felippetuma/vinheria-full/docs/imgs/dashboard/dashboard.png

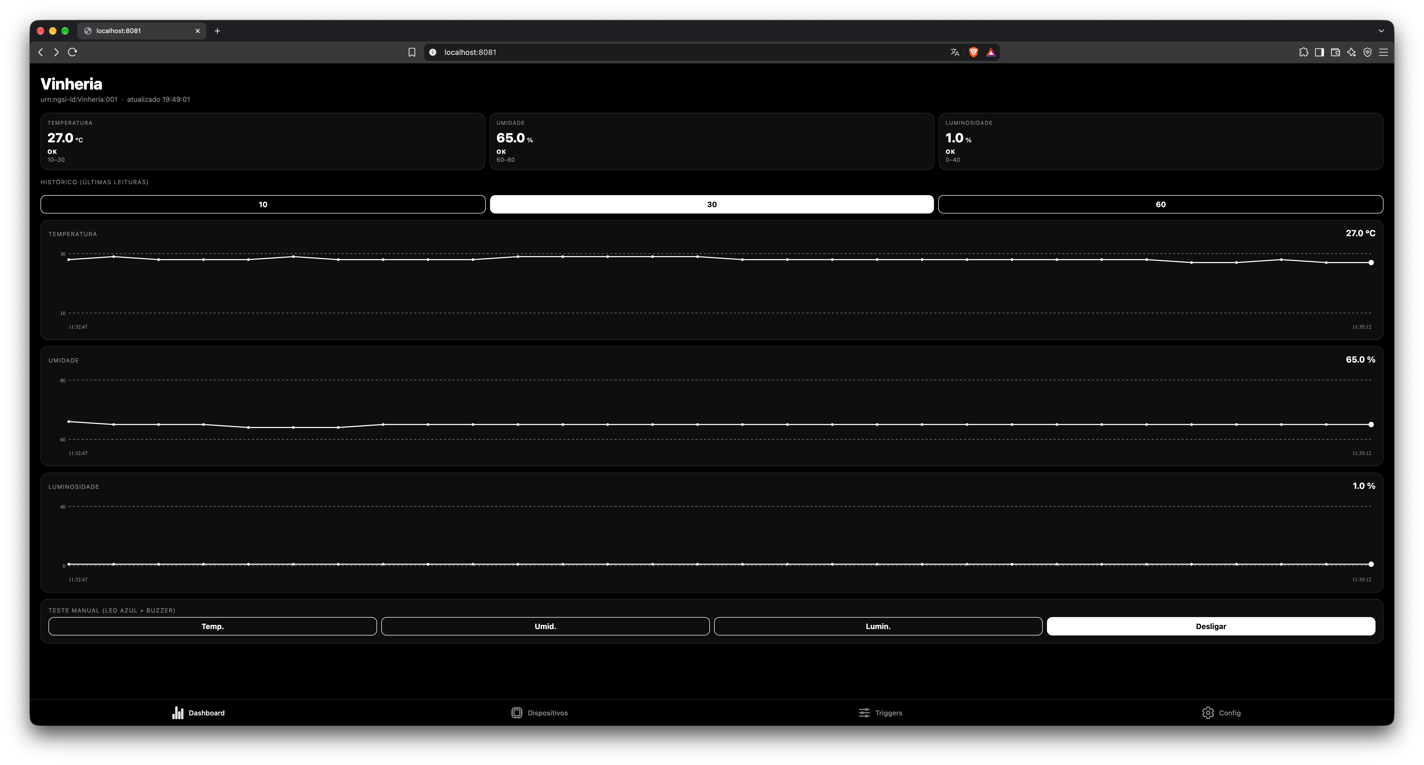
docs/imgs/dashboard/dashboard.png
