felippetuma/vinheria-full/docs/imgs/dashboard/dispositivos.png

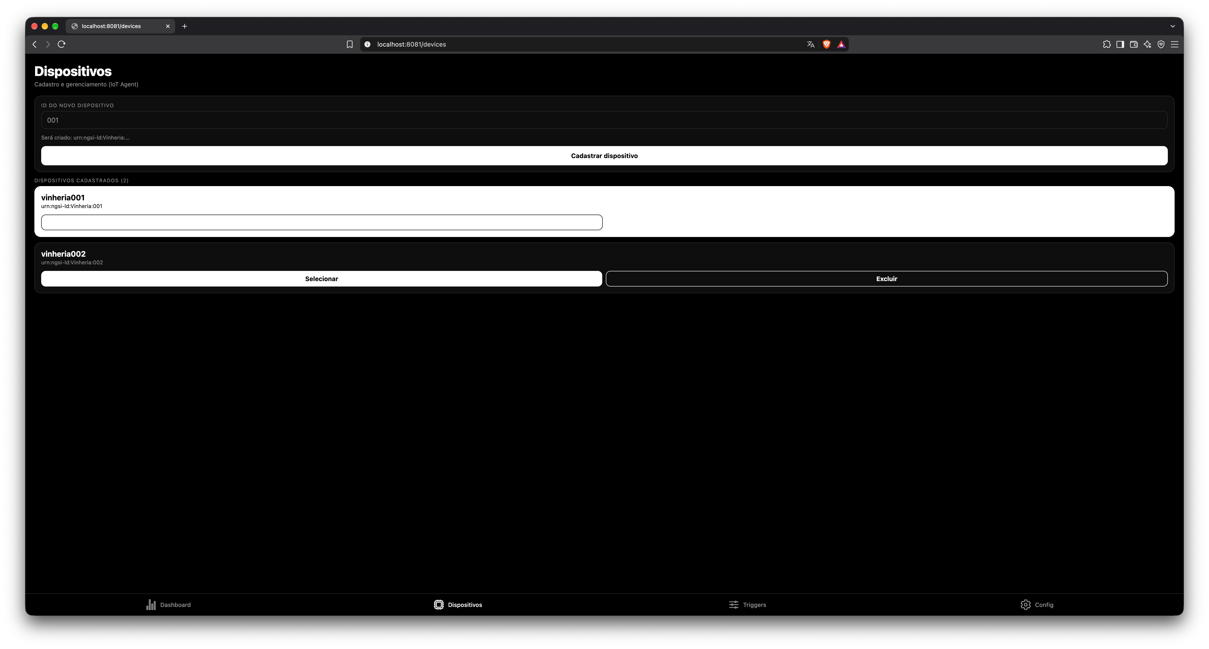
docs/imgs/dashboard/dispositivos.png
