felippetuma/vinheria-full/docs/imgs/dashboard/triggers.png

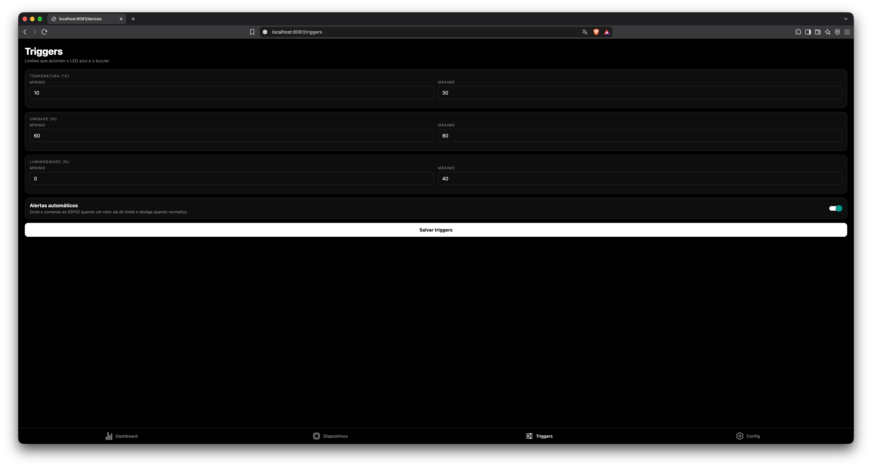
docs/imgs/dashboard/triggers.png
