felippetuma/vinheria-full/docs/imgs/prototipo/aberto.png

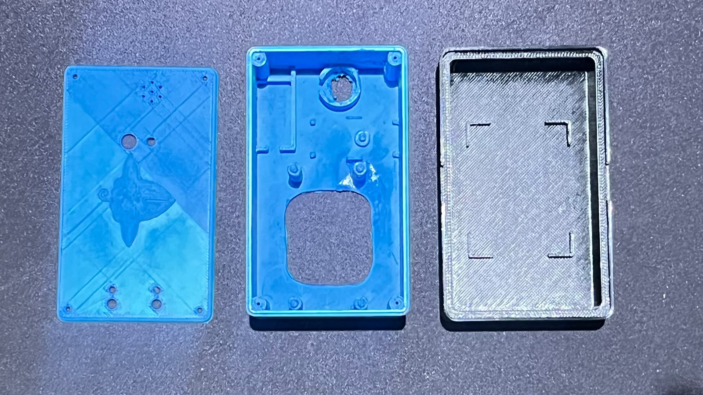
docs/imgs/prototipo/aberto.png
