felippetuma/vinheria-full/docs/imgs/prototipo/encapsulamento.png

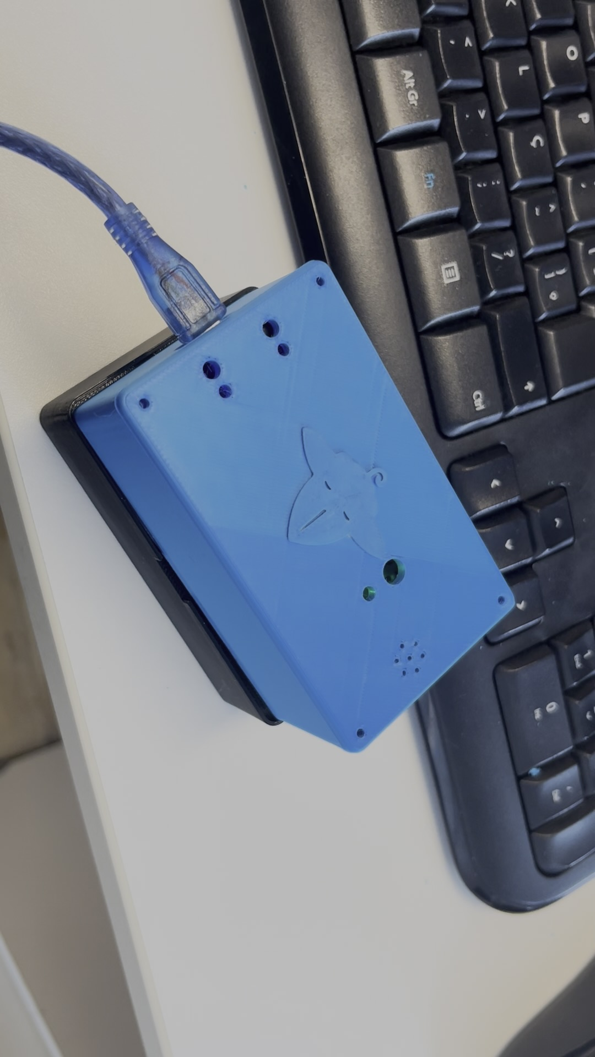
docs/imgs/prototipo/encapsulamento.png
