felippetuma/vinheria-full/docs/imgs/prototipo/monitor-serial.png

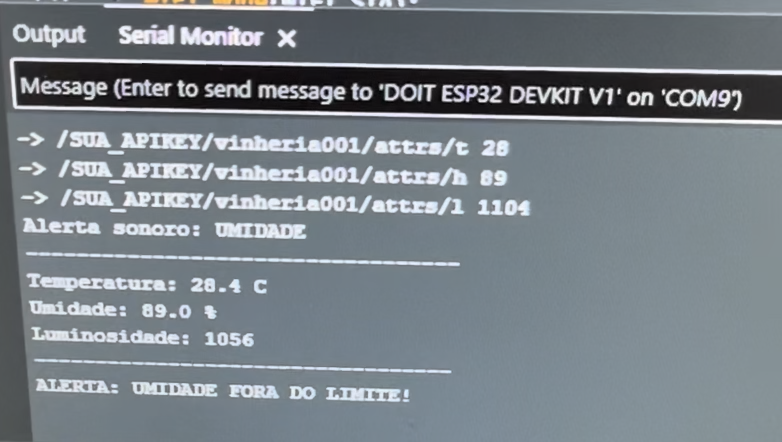
docs/imgs/prototipo/monitor-serial.png
