felippetuma/vinheria-full/docs/imgs/prototipo/onshape.png

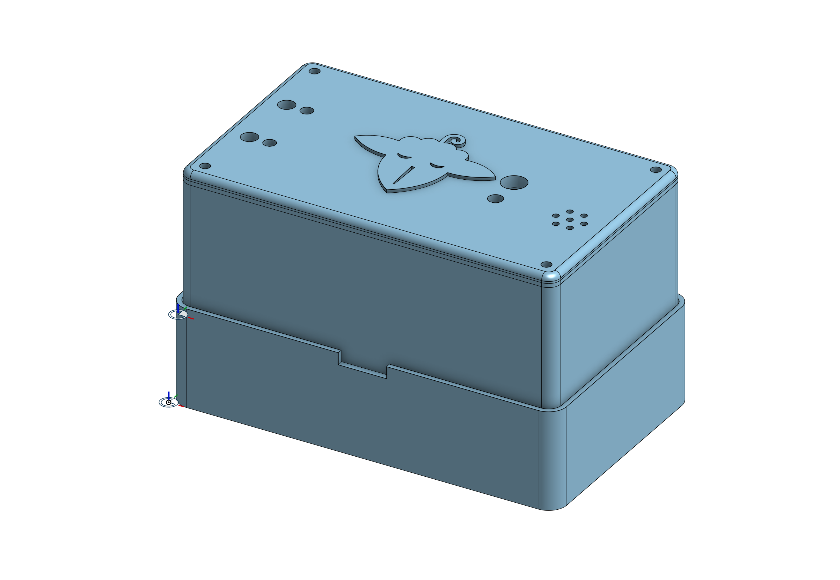
docs/imgs/prototipo/onshape.png
