felippetuma/vinheria-full/encapsulamento/stl/Caixa2.stl

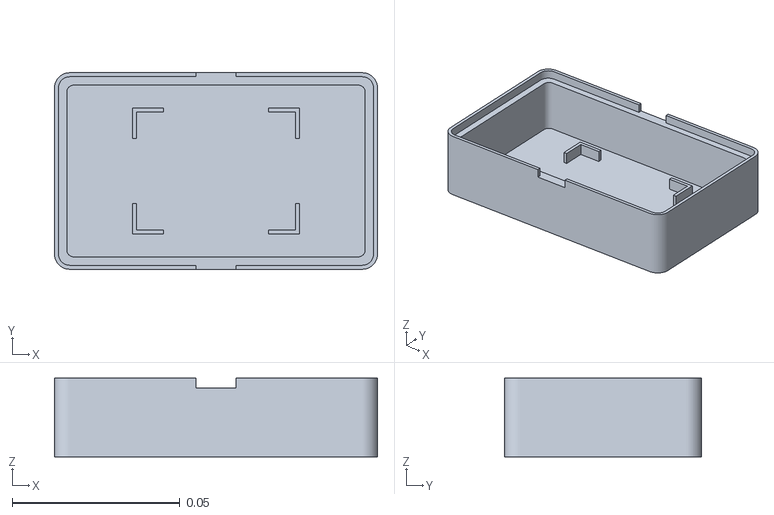
[picture p11: CAD file, 2026-10-31]
encapsulamento/stl/Caixa2.stl
0.0963 x 0.0586 x 0.0235
