felippetuma/vinheria-full/encapsulamento/stl/Tampa.stl

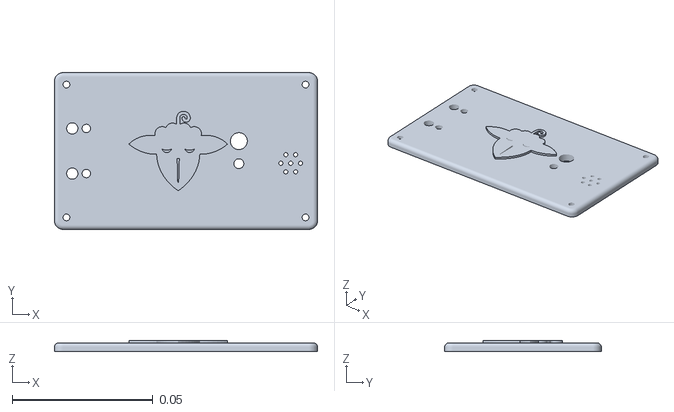
[picture p12: CAD file, 2026-10-31]
encapsulamento/stl/Tampa.stl
0.0933 x 0.0556 x 0.0038
