felippetuma/vinheria-full/encapsulamento/stl/Caixa1.stl

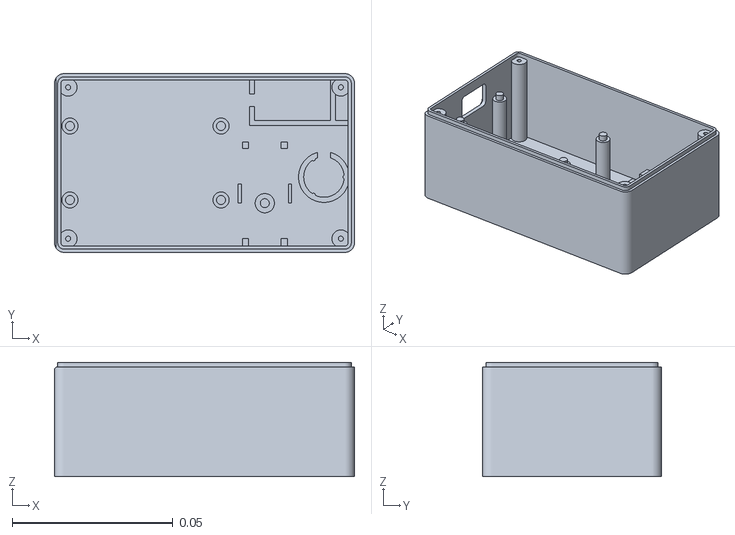
[picture p13: CAD file, 2026-10-31]
encapsulamento/stl/Caixa1.stl
0.0933 x 0.0556 x 0.0355
