felippetuma/vinheria-full/docs/imgs/prototipo/montagem.png

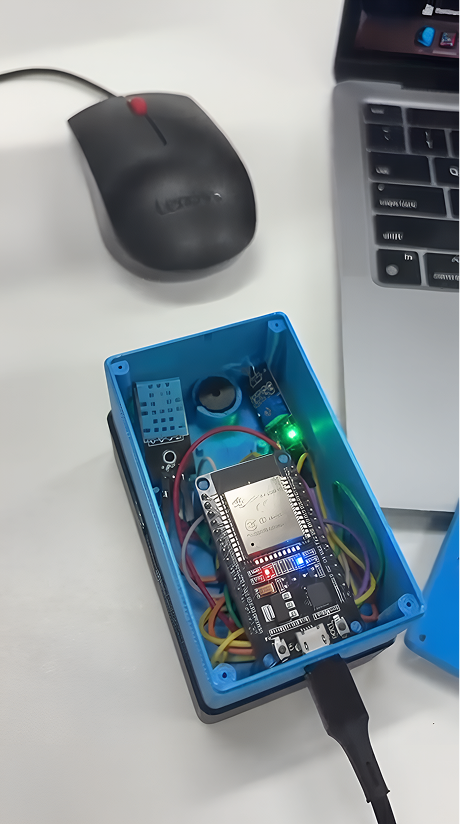
docs/imgs/prototipo/montagem.png
