felippetuma/vinheria-full/(commit log)

2026-10-30 fix: Corrige acesso ao servidor e demais valores de luminisidade
2026-10-30 feat: modifica os valores max e min de luminosidade
2026-10-30 fix: Medição dos indices de luminosidade
    [vinheria_full.ino]
2026-10-30 docs: link de acesso ao link do projeto no wokwi
2026-10-30 feat: adiciona arquivos de configuração do mosquitto
2026-10-31 feat: modifica parametros de reconhecimento coerentes com o .ino
2026-10-31 docs: Remove linha de explicação não pertinete
2026-10-31 docs: manual de instalação e uso do software
2026-10-31 docs: manual de configuração, instação e uso do hardware
2026-10-31 chore: Arquivos SLT do encapsulamento do projeto Vinheria Full
    [Caixa1.stl, Caixa2.stl, Tampa.stl]
